chaffneue/houston/eagle/houston-schematic.pdf

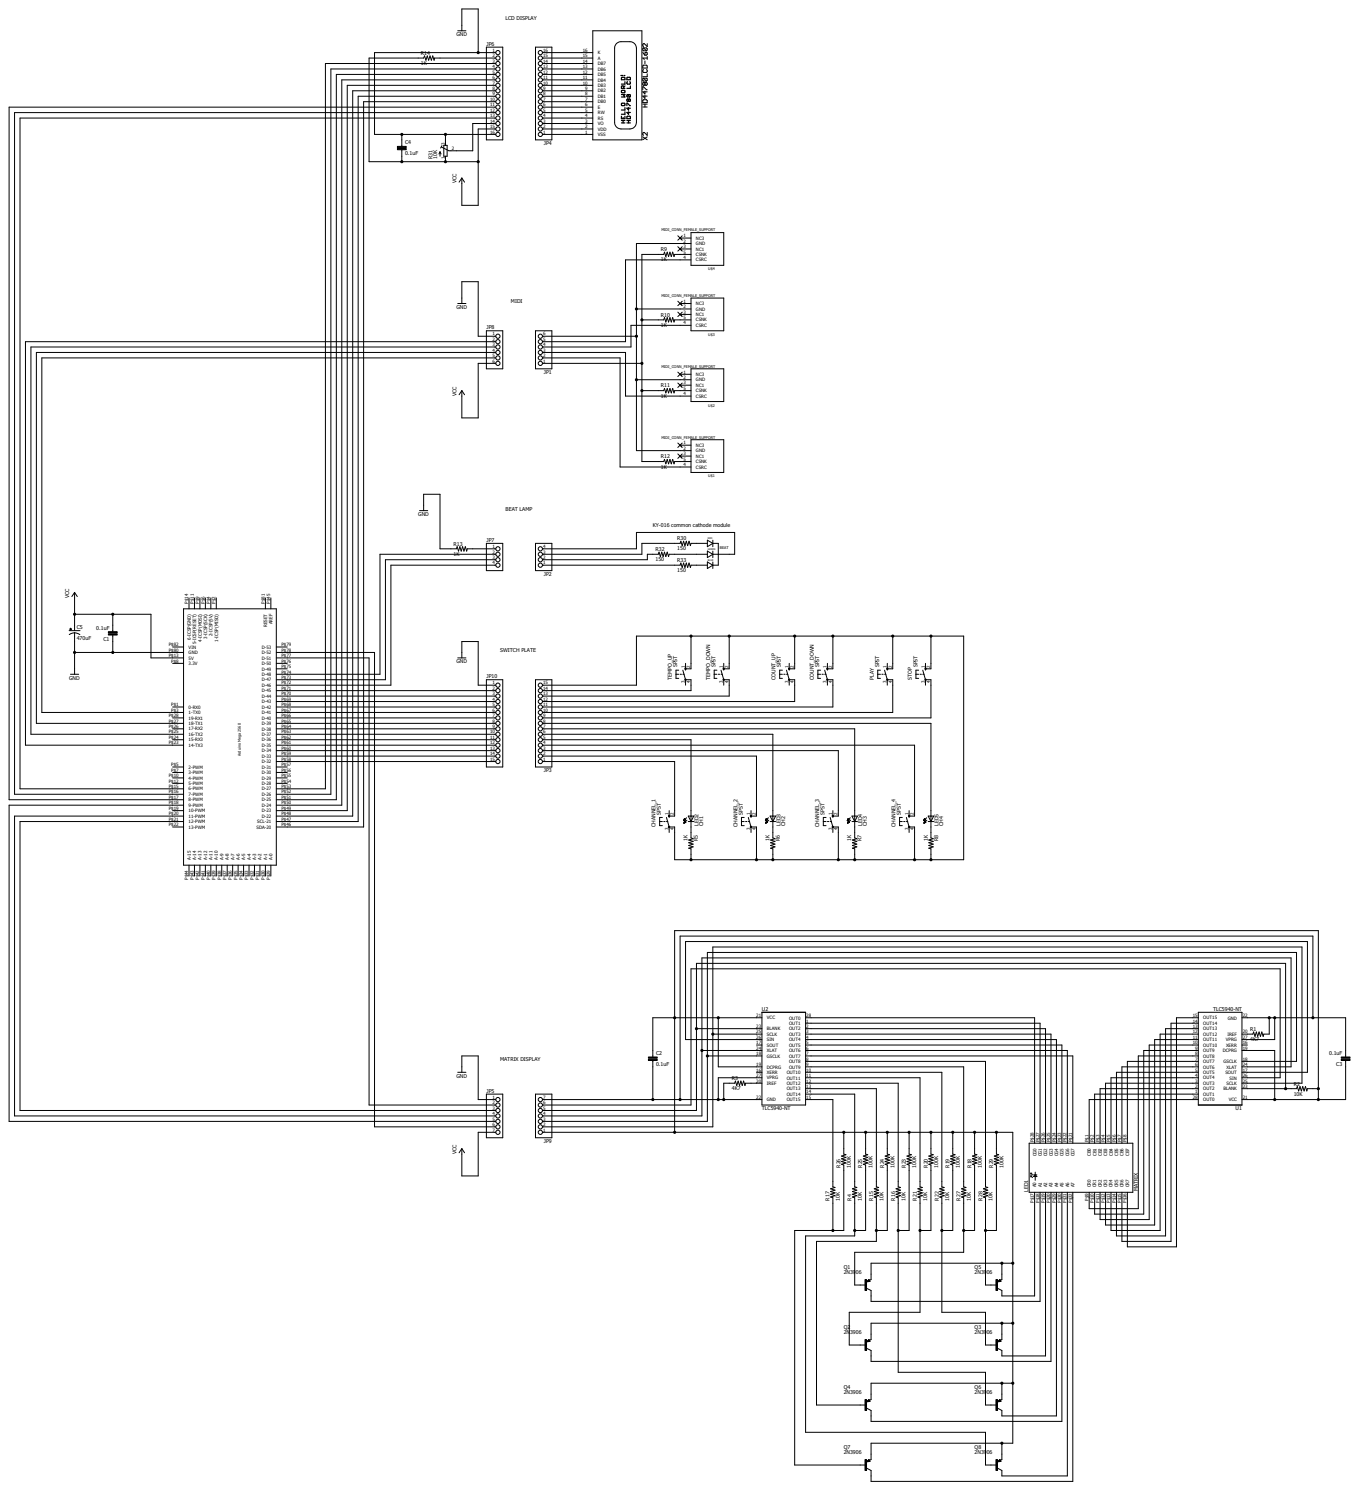
[picture p1: page 1]

KY-016 common cathode module
