chaffneue/houston/illustrator/houston-back-panel.pdf

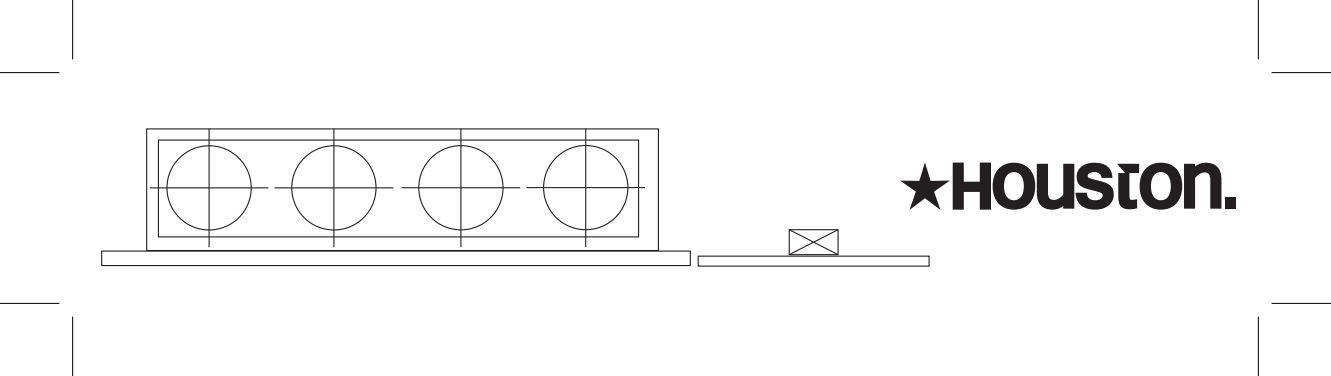
[picture p2: page 1]
