chaffneue/houston/illustrator/houston-front-panel.pdf

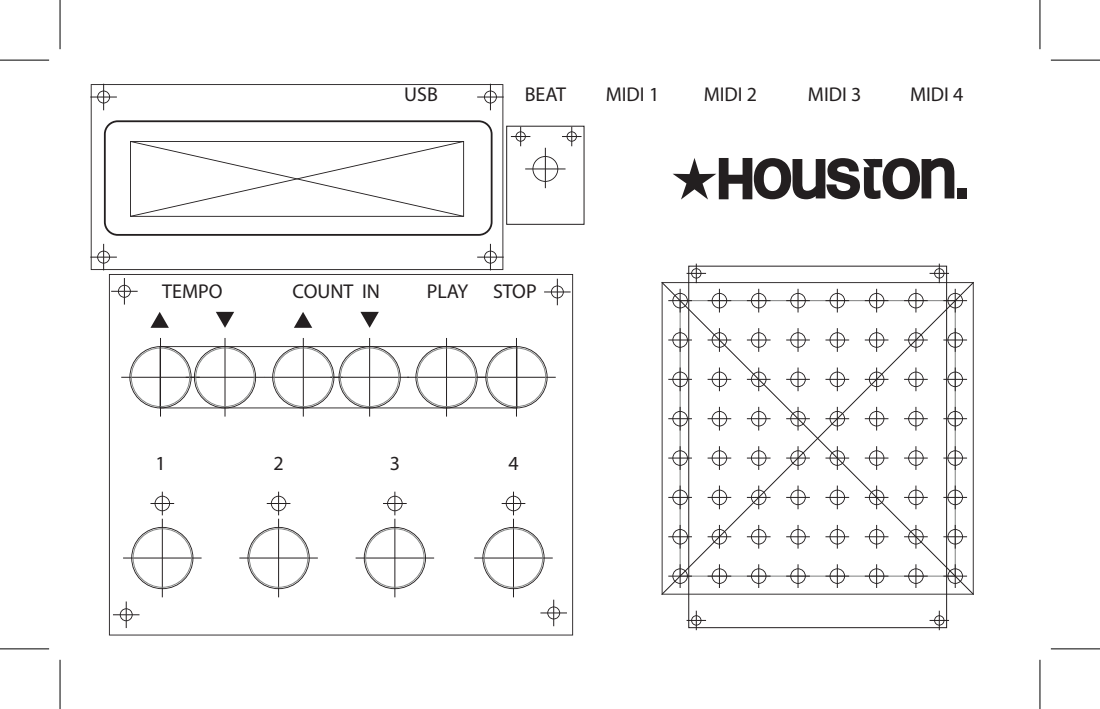
[picture p3: page 1]
TEMPO; COUNT IN; PLAY STOP; USB; BEAT; MIDI 1; MIDI 2; MIDI 3; MIDI 4
