chaffneue/houston/eagle/houston.sch

## EAGLE design eagle/houston.sch (2015-12-17)

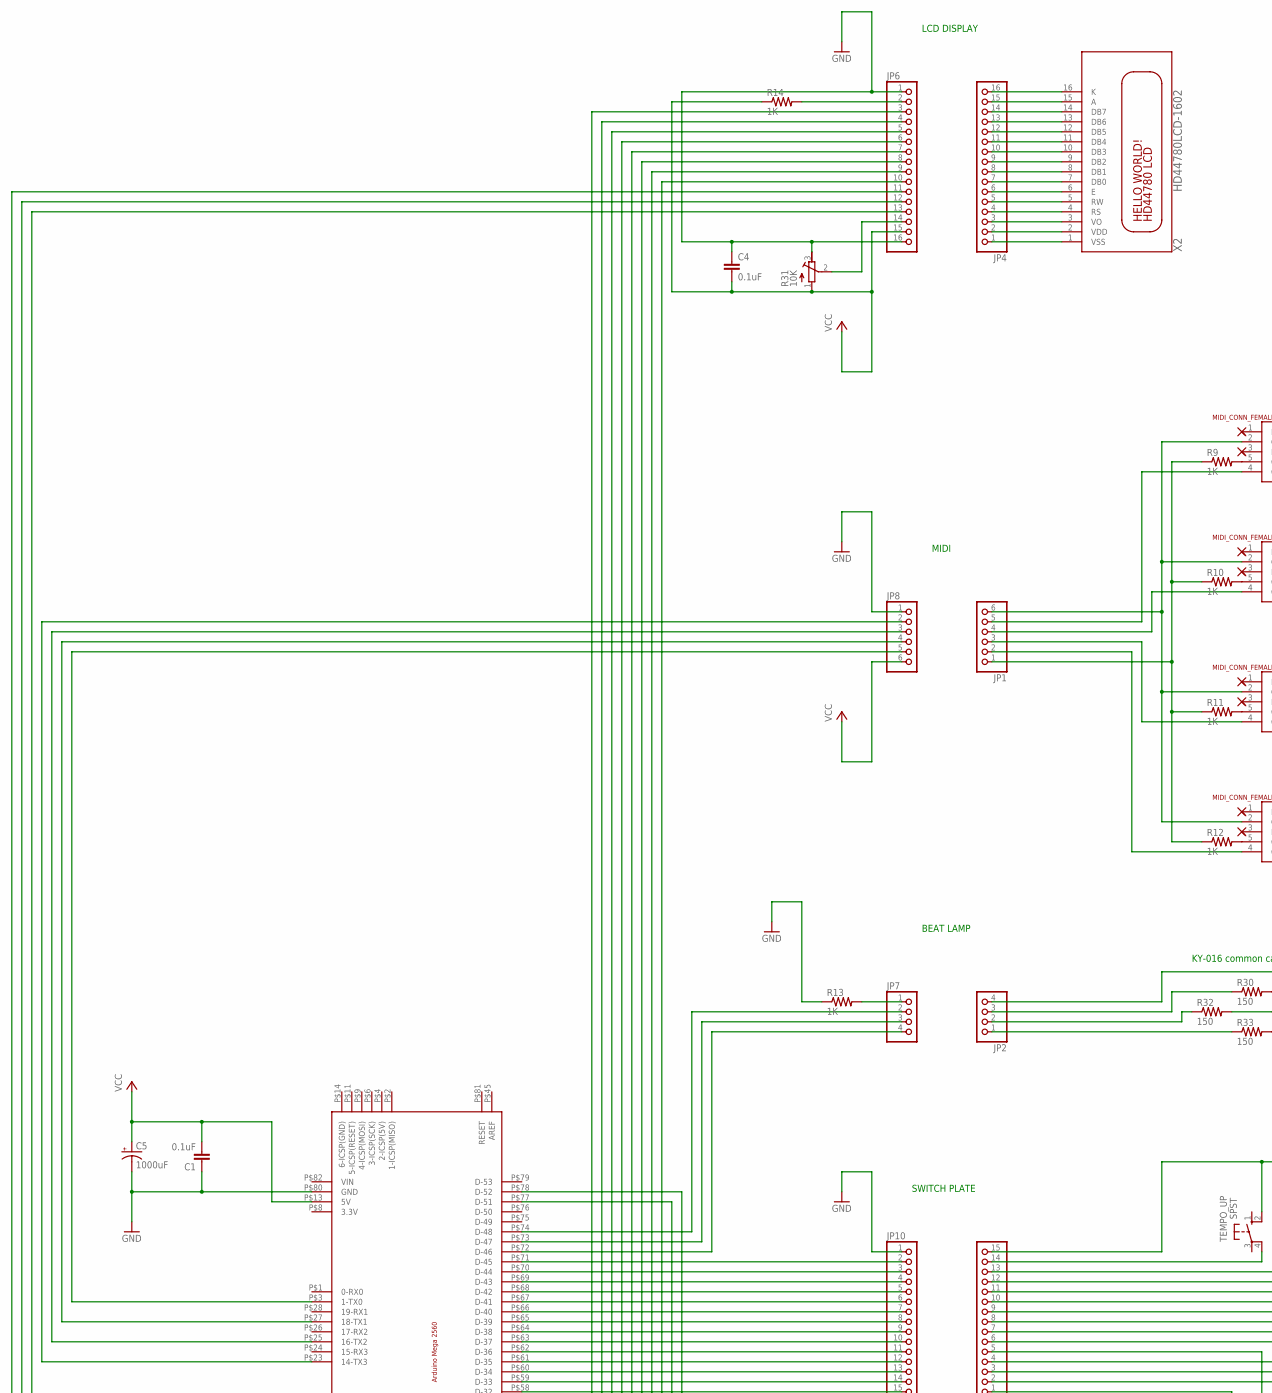
[picture p4: schematic houston.sch, part in row 1, column 1]

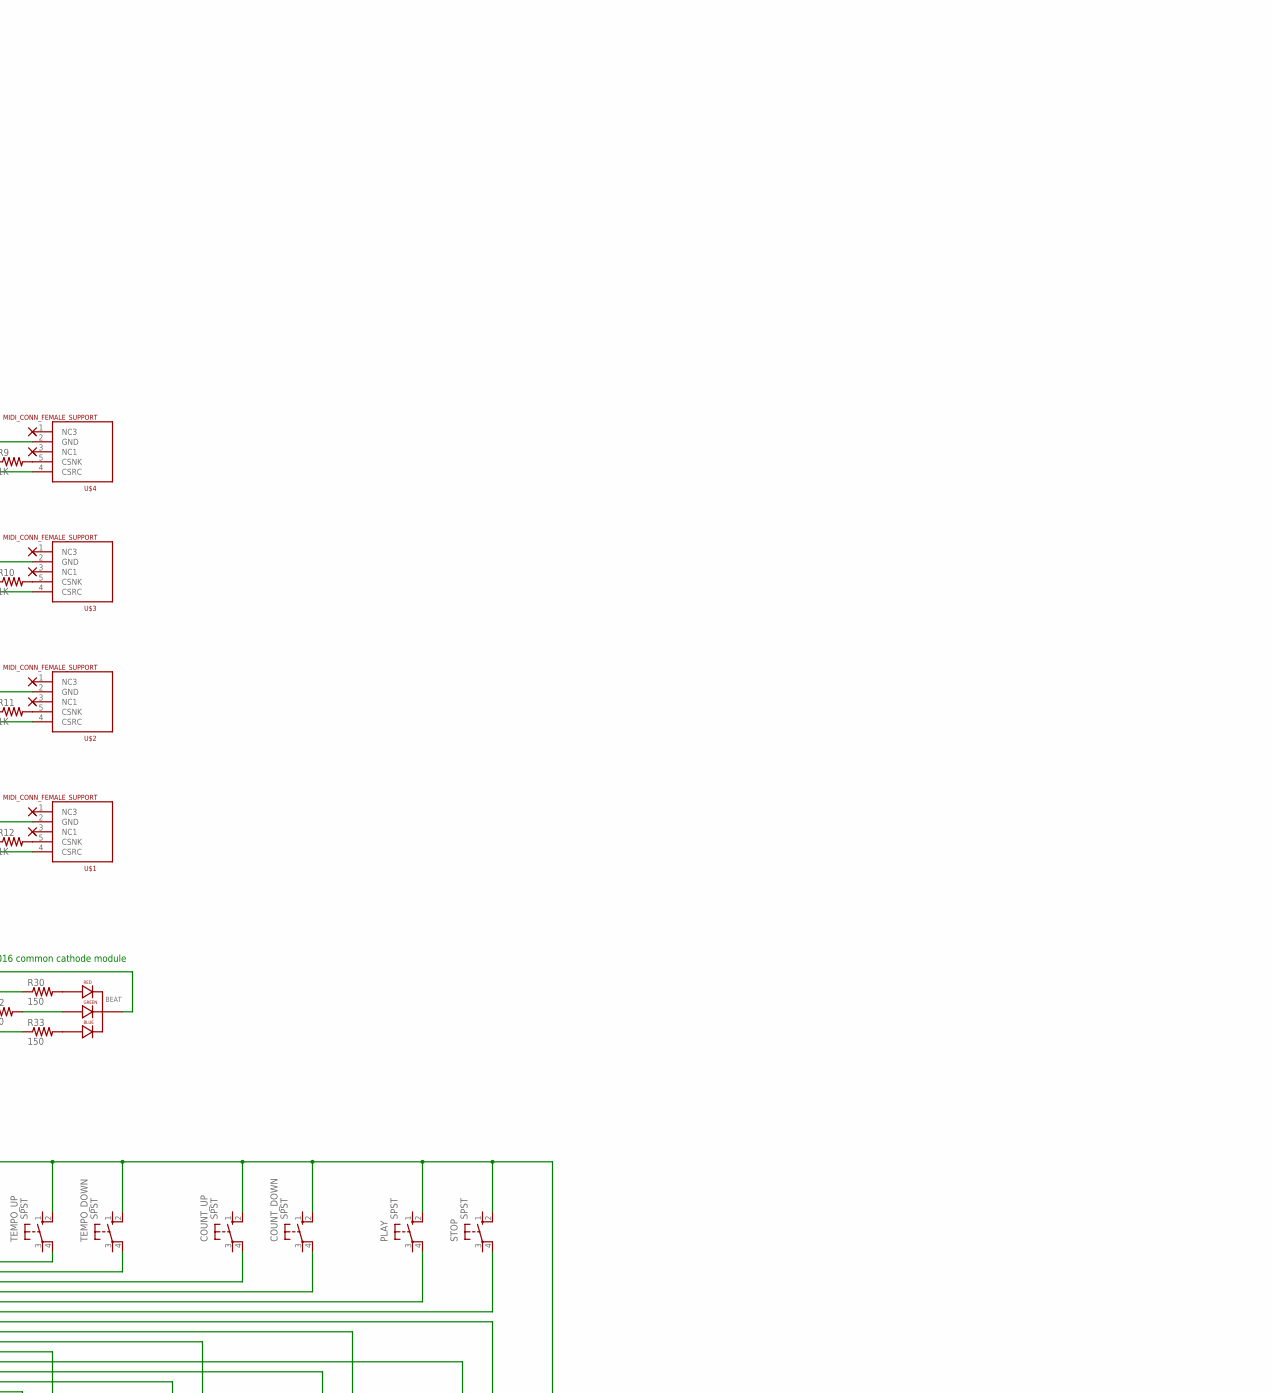
[picture p5: schematic houston.sch, part in row 1, column 2]

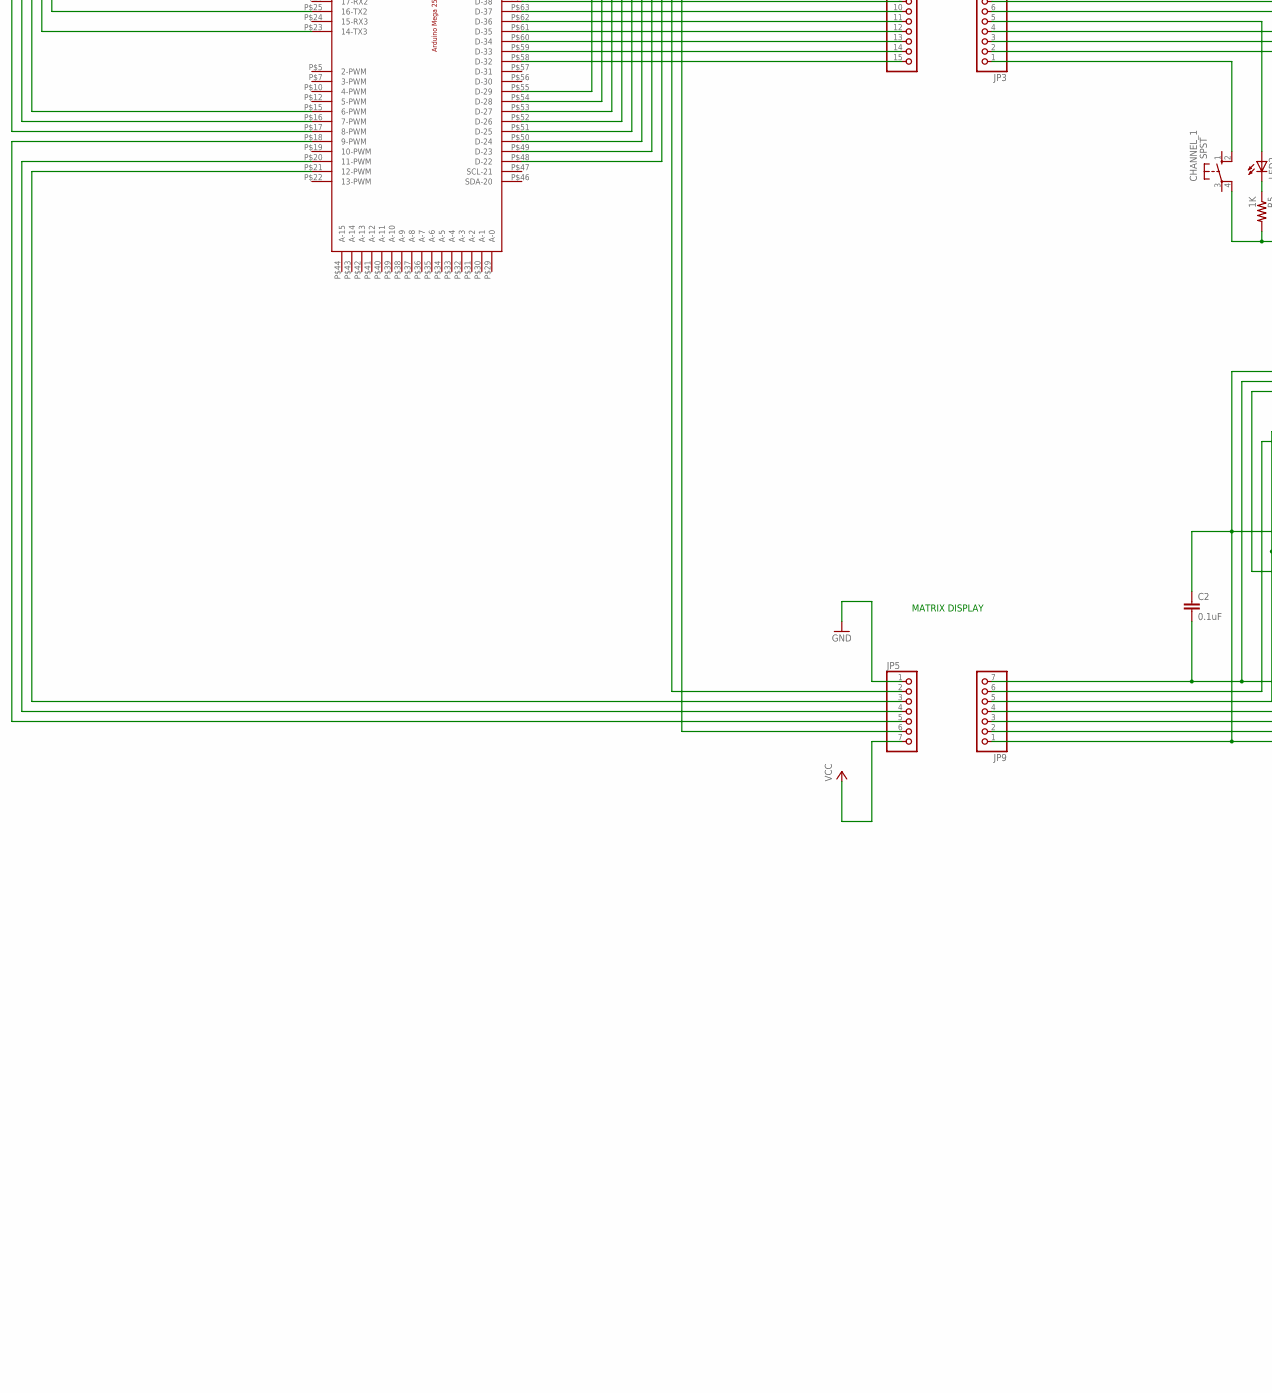
[picture p6: schematic houston.sch, part in row 2, column 1]

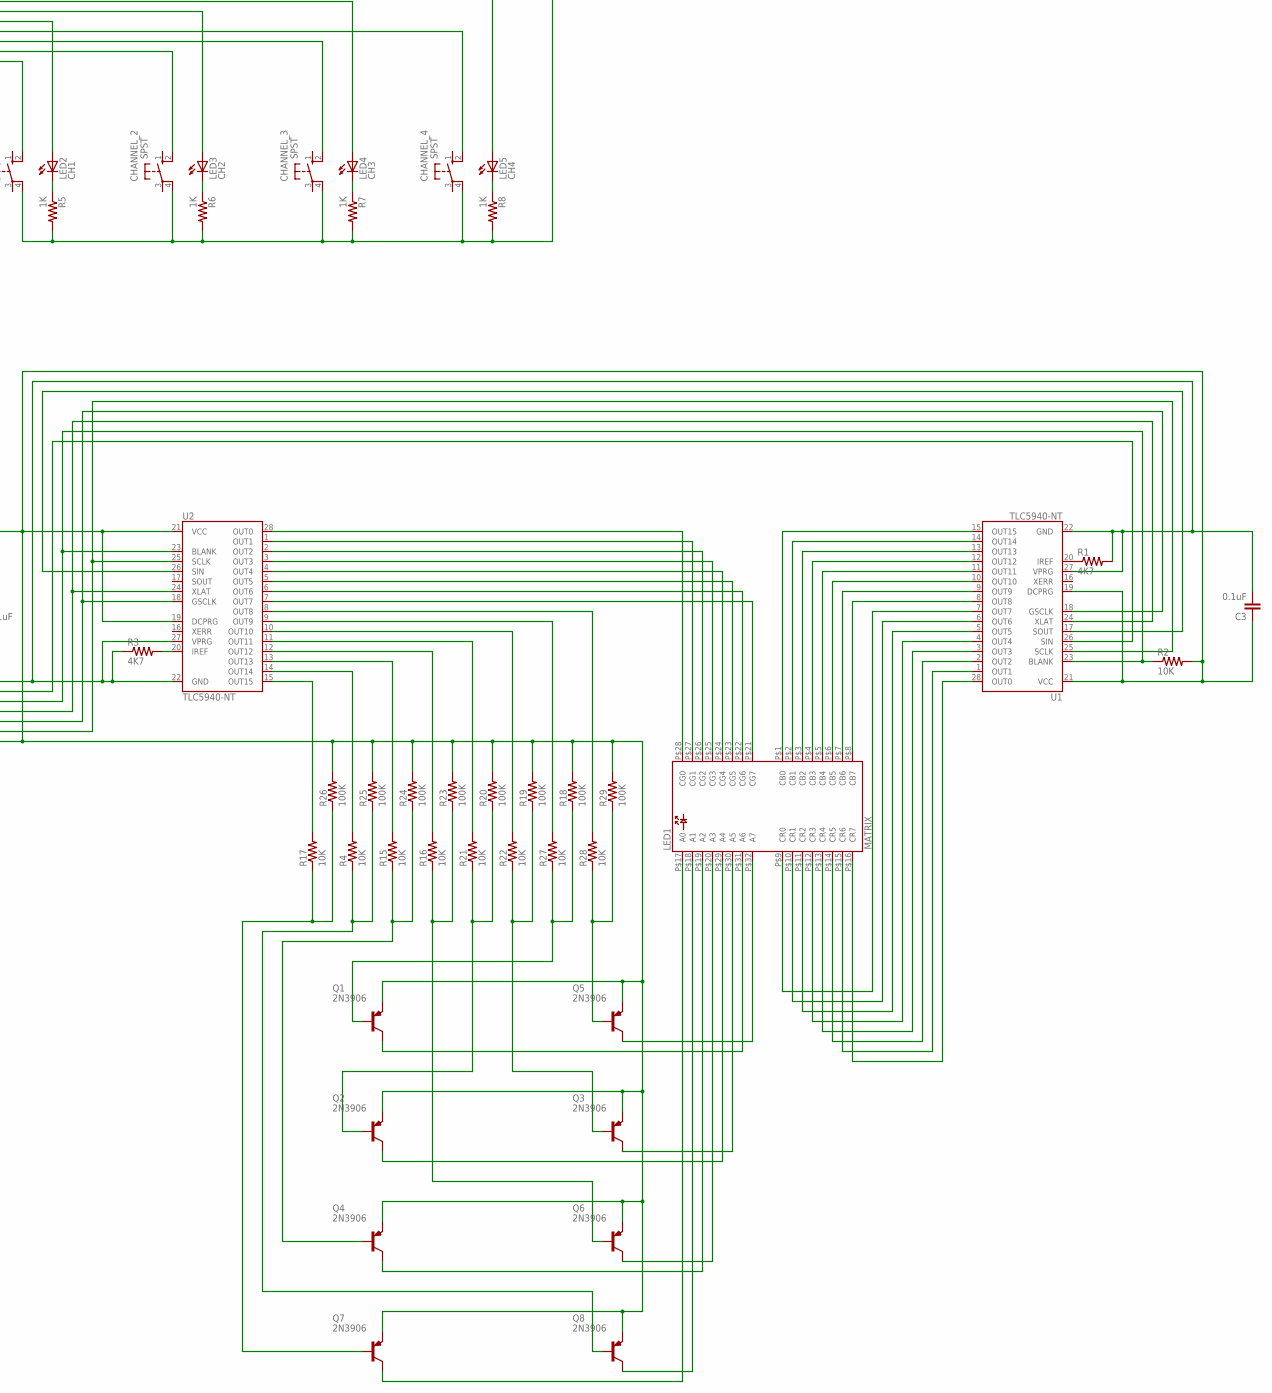
[picture p7: schematic houston.sch, part in row 2, column 2]

Parts:
BEAT: LED-RGB-CC-THRUCLEAR; LED-RGB-THRU
C1, C2, C3, C4: 0.1uF; CAP-PTH-SMALLEZ
C5: 1000uF; CPOL-RADIAL-1000UF-25V
CHANNEL_1, CHANNEL_2, CHANNEL_3, CHANNEL_4: SPST; B3F-40XX-ROUND
COUNT_DOWN: SPST; B3F-40XX-ROUND
COUNT_UP: SPST; B3F-40XX-ROUND
JP1: PINHD-1X6/90; 1X06/90
JP2: PINHD-1X4/90; 1X04/90
JP3: PINHD-1X15/90; 1X15/90
JP4, JP6: PINHD-1X16; 1X16
JP5: PINHD-1X7; 1X07
JP7: PINHD-1X4; 1X04
JP8: PINHD-1X6; 1X06
JP9: PINHD-1X7/90; 1X07/90
JP10: PINHD-1X15-CB; 1X15-CB
LED1: MATRIX; ORM-2088-RGB-5
LED2: CH1; LED3MM
LED3: CH2; LED3MM
LED4: CH3; LED3MM
LED5: CH4; LED3MM
PLAY: SPST; B3F-40XX-ROUND
Q1, Q2, Q3, Q4, Q5, Q6, Q7, Q8: 2N3906; TO92
R1, R3: 4K7; 0411V
R2: 10K; 0411V
R4, R15, R16, R17, R21, R22, R27, R28: 10K; 0207/10
R5, R6, R7, R8, R14: 1K; 0204/7
R9, R10, R11, R12, R13: 1K; 0207/2V
R18, R19, R20, R23, R24, R25, R26, R29: 100K; 0207/10
R30, R32, R33: 150; 0204/7
R31: 10K; RTRIM3296W
STOP: SPST; B3F-40XX-ROUND
TEMPO_DOWN: SPST; B3F-40XX-ROUND
TEMPO_UP: SPST; B3F-40XX-ROUND
U1, U2: TLC5940-NT; DIL28-3
U$1, U$2, U$3, U$4: MIDI_CONN_FEMALE_SUPPORT; DIN_5_FEMALE_SUPPORT
U$6: 2560; MEDUINO2560
X2: HD44780LCD-1602; LCD1602

Connections:
GND: C1.1, C4.1, C5.2 (-), JP5.1, JP6.1, JP6.16, JP8.1, JP10.1, R13.1, R31.3 (E), U$6.P$80 (GND)
unnamed: LED2.K (C), R5.1
unnamed: LED3.K (C), R6.1
unnamed: LED4.K (C), R7.1
unnamed: LED5.K (C), R8.1
unnamed: JP3.9, STOP.4 (P1)
unnamed: JP3.10, PLAY.4 (P1)
unnamed: COUNT_DOWN.4 (P1), JP3.11
unnamed: CHANNEL_1.2 (S1), JP3.1
unnamed: CHANNEL_2.2 (S1), JP3.2
unnamed: CHANNEL_3.2 (S1), JP3.3
unnamed: CHANNEL_4.2 (S1), JP3.4
unnamed: JP3.5, LED2.A
unnamed: JP3.6, LED3.A
unnamed: JP3.7, LED4.A
unnamed: JP1.4, U$3.4 (CSRC)
unnamed: JP1.3, U$2.4 (CSRC)
unnamed: JP1.2, U$1.4 (CSRC)
unnamed: R9.2, U$4.5 (CSNK)
unnamed: R10.2, U$3.5 (CSNK)
unnamed: R11.2, U$2.5 (CSNK)
unnamed: R12.2, U$1.5 (CSNK)
unnamed: JP3.8, LED5.A
unnamed: JP1.5, U$4.4 (CSRC)
unnamed: COUNT_UP.4 (P1), JP3.12
unnamed: JP3.13, TEMPO_DOWN.4 (P1)
unnamed: JP3.14, TEMPO_UP.4 (P1)
unnamed: CHANNEL_1.4 (P1), CHANNEL_2.4 (P1), CHANNEL_3.4 (P1), CHANNEL_4.4 (P1), COUNT_DOWN.2 (S1), COUNT_UP.2 (S1), JP3.15, PLAY.2 (S1), R5.2, R6.2, R7.2, R8.2, STOP.2 (S1), TEMPO_DOWN.2 (S1), TEMPO_UP.2 (S1)
unnamed: JP1.1, R9.1, R10.1, R11.1, R12.1
unnamed: BEAT.1 (RED_CATHODE), R30.2
unnamed: BEAT.2 (CATHODE), JP2.4
unnamed: JP2.1, R33.1
unnamed: JP2.3, R30.1
unnamed: JP7.1, R13.2
unnamed: BEAT.3 (GREEN_CATHODE), R32.2
unnamed: JP1.6, U$1.2 (GND), U$2.2 (GND), U$3.2 (GND), U$4.2 (GND)
unnamed: BEAT.4 (BLUE_CATHODE), R33.2
unnamed: JP2.2, R32.1
unnamed: LED1.P$1 (CB0), U1.15 (OUT15)
unnamed: LED1.P$2 (CB1), U1.14 (OUT14)
unnamed: JP5.2, U$6.P$77 (D-51)
unnamed: JP6.10, U$6.P$48 (D-22)
unnamed: LED1.P$3 (CB2), U1.13 (OUT13)
unnamed: LED1.P$4 (CB3), U1.12 (OUT12)
unnamed: JP6.9, U$6.P$49 (D-23)
unnamed: JP6.8, U$6.P$50 (D-24)
unnamed: JP6.2, R14.2
unnamed: LED1.P$5 (CB4), U1.11 (OUT11)
unnamed: LED1.P$6 (CB5), U1.10 (OUT10)
unnamed: LED1.P$7 (CB6), U1.9 (OUT9)
unnamed: LED1.P$8 (CB7), U1.8 (OUT8)
unnamed: LED1.P$9 (CR0), U1.7 (OUT7)
unnamed: LED1.P$10 (CR1), U1.6 (OUT6)
unnamed: LED1.P$11 (CR2), U1.5 (OUT5)
unnamed: LED1.P$12 (CR3), U1.4 (OUT4)
unnamed: LED1.P$13 (CR4), U1.3 (OUT3)
unnamed: LED1.P$14 (CR5), U1.2 (OUT2)
unnamed: LED1.P$15 (CR6), U1.1 (OUT1)
unnamed: LED1.P$16 (CR7), U1.28 (OUT0)
unnamed: LED1.P$29 (A4), Q2.1 (C)
unnamed: LED1.P$19 (A2), Q4.1 (C)
unnamed: LED1.P$17 (A0), Q7.1 (C)
unnamed: LED1.P$31 (A6), Q1.1 (C)
unnamed: LED1.P$28 (CG0), U2.28 (OUT0)
unnamed: LED1.P$27 (CG1), U2.1 (OUT1)
unnamed: LED1.P$26 (CG2), U2.2 (OUT2)
unnamed: LED1.P$25 (CG3), U2.3 (OUT3)
unnamed: LED1.P$24 (CG4), U2.4 (OUT4)
unnamed: LED1.P$23 (CG5), U2.5 (OUT5)
unnamed: LED1.P$22 (CG6), U2.6 (OUT6)
unnamed: LED1.P$21 (CG7), U2.7 (OUT7)
unnamed: R28.2, U2.8 (OUT8)
unnamed: C2.1, C3.1, JP9.1, Q1.3 (E), Q2.3 (E), Q3.3 (E), Q4.3 (E), Q5.3 (E), Q6.3 (E), Q7.3 (E), Q8.3 (E), R2.2, R18.2, R19.2, R20.2, R23.2, R24.2, R25.2, R26.2, R29.2, U1.19 (DCPRG), U1.21 (VCC), U2.19 (DCPRG), U2.21 (VCC)
unnamed: U1.17 (SOUT), U2.26 (SIN)
unnamed: R1.1, U1.20 (IREF)
unnamed: JP9.2, U1.25 (SCLK), U2.25 (SCLK)
unnamed: JP9.3, U1.18 (GSCLK), U2.18 (GSCLK)
unnamed: JP9.4, U1.24 (XLAT), U2.24 (XLAT)
unnamed: JP9.5, R2.1, U1.23 (BLANK), U2.23 (BLANK)
unnamed: JP9.6, U1.26 (SIN)
unnamed: JP5.6, U$6.P$78 (D-52)
unnamed: R3.2, U2.20 (IREF)
unnamed: JP10.15, U$6.P$58 (D-32)
unnamed: Q3.2 (B), R19.1, R22.1
unnamed: R27.2, U2.9 (OUT9)
unnamed: Q5.2 (B), R28.1, R29.1
unnamed: Q1.2 (B), R18.1, R27.1
unnamed: LED1.P$18 (A1), Q8.1 (C)
unnamed: JP5.3, U$6.P$21 (12-PWM)
unnamed: Q6.2 (B), R16.1, R23.1
unnamed: Q4.2 (B), R15.1, R24.1
unnamed: C2.2, C3.2, JP9.7, R1.2, R3.1, U1.22 (GND), U1.27 (VPRG), U2.22 (GND), U2.27 (VPRG)
unnamed: LED1.P$20 (A3), Q6.1 (C)
unnamed: LED1.P$30 (A5), Q3.1 (C)
unnamed: Q7.2 (B), R17.1, R26.1
unnamed: JP5.4, U$6.P$20 (11-PWM)
unnamed: Q8.2 (B), R4.1, R25.1
unnamed: R22.2, U2.10 (OUT10)
unnamed: R21.2, U2.11 (OUT11)
unnamed: LED1.P$32 (A7), Q5.1 (C)
unnamed: JP5.5, U$6.P$18 (9-PWM)
unnamed: R16.2, U2.12 (OUT12)
unnamed: JP10.14, U$6.P$59 (D-33)
unnamed: JP6.7, U$6.P$51 (D-25)
unnamed: JP6.12, U$6.P$16 (7-PWM)
unnamed: JP6.11, U$6.P$17 (8-PWM)
unnamed: R15.2, U2.13 (OUT13)
unnamed: R4.2, U2.14 (OUT14)
unnamed: R17.2, U2.15 (OUT15)
unnamed: JP4.16, X2.16 (K)
unnamed: JP4.15, X2.15 (A)
unnamed: JP4.14, X2.14 (DB7)
unnamed: JP4.13, X2.13 (DB6)
unnamed: JP4.12, X2.12 (DB5)
unnamed: JP4.11, X2.11 (DB4)
unnamed: JP4.10, X2.10 (DB3)
unnamed: JP4.9, X2.9 (DB2)
unnamed: JP4.8, X2.8 (DB1)
unnamed: JP4.7, X2.7 (DB0)
unnamed: JP4.6, X2.6 (E)
unnamed: JP10.13, U$6.P$60 (D-34)
unnamed: JP4.5, X2.5 (RW)
unnamed: Q2.2 (B), R20.1, R21.1
unnamed: JP10.12, U$6.P$61 (D-35)
unnamed: JP10.11, U$6.P$62 (D-36)
unnamed: JP4.4, X2.4 (RS)
unnamed: JP4.3, X2.3 (VO)
unnamed: JP6.6, U$6.P$52 (D-26)
unnamed: JP6.5, U$6.P$53 (D-27)
unnamed: JP6.4, U$6.P$54 (D-28)
unnamed: JP10.10, U$6.P$63 (D-37)
unnamed: JP6.3, U$6.P$55 (D-29)
unnamed: JP6.13, U$6.P$15 (6-PWM)
unnamed: JP10.9, U$6.P$64 (D-38)
unnamed: JP10.8, U$6.P$65 (D-39)
unnamed: JP10.7, U$6.P$66 (D-40)
unnamed: JP10.6, U$6.P$67 (D-41)
unnamed: JP10.5, U$6.P$68 (D-42)
unnamed: JP10.4, U$6.P$69 (D-43)
unnamed: JP10.3, U$6.P$70 (D-44)
unnamed: JP10.2, U$6.P$71 (D-45)
unnamed: JP7.4, U$6.P$72 (D-46)
unnamed: JP7.3, U$6.P$73 (D-47)
unnamed: JP7.2, U$6.P$74 (D-48)
unnamed: JP8.5, U$6.P$3 (1-TX0)
unnamed: JP8.4, U$6.P$27 (18-TX1)
unnamed: JP8.3, U$6.P$25 (16-TX2)
unnamed: JP8.2, U$6.P$23 (14-TX3)
unnamed: JP6.14, R31.2 (S)
VCC: C1.2, C4.2, C5.1 (+), JP5.7, JP6.15, JP8.6, R14.1, R31.1 (A), U$6.P$13 (5V)
VDD: JP4.2, X2.2 (VDD)
VSS: JP4.1, X2.1 (VSS)

Notes on the sheet:
SWITCH PLATE
BEAT LAMP
MIDI
LCD DISPLAY
KY-016 common cathode module
MATRIX DISPLAY
