chaffneue/houston/(commit log)

2015-11-25 Schematic File
    Adding schematics to project
    [houston.sch]
2015-12-17 Updating schematic files and source code
    [houston.sch]
2016-01-02 Adding case designs
    Case designs as an AI file
2016-01-06 updating art with new measurements
    Adding back panel and tweaking the drill locations of the top panel
2016-01-11 Adding channel indicators to the LED matrix
2016-01-12 Updating Art and generating PDF versions of the schematics and case/decals
2017-03-22 Updating start and stop behavior to be more consistent
    - Making stop and start behaviour more consistent through the app
    - Adding a song pointer reset to ensure patterns start from the
    beginning
    - Moving midi start to immediatly before the ticks while enqueued so the
    gear doesn't time out
    [houston.h, houston.ino]
